Vizdrive/VizDrive_WRO2025/models/README.md

# Models Folder

Here you can find all the .stl and .glb models of every 3D modeled part of our robot.

The .glb models are used for the HTML embeds hosted in GitHub pages. 
We designed these embeds for a more interactive visualization of the models and their colors in the real-life robot. However, the .stl files can also be visualized directly in GitHub.

The designs included in this file directory are:

## 1. Chassis Model

### 1. [Chassis](./chassis/chassis.stl)
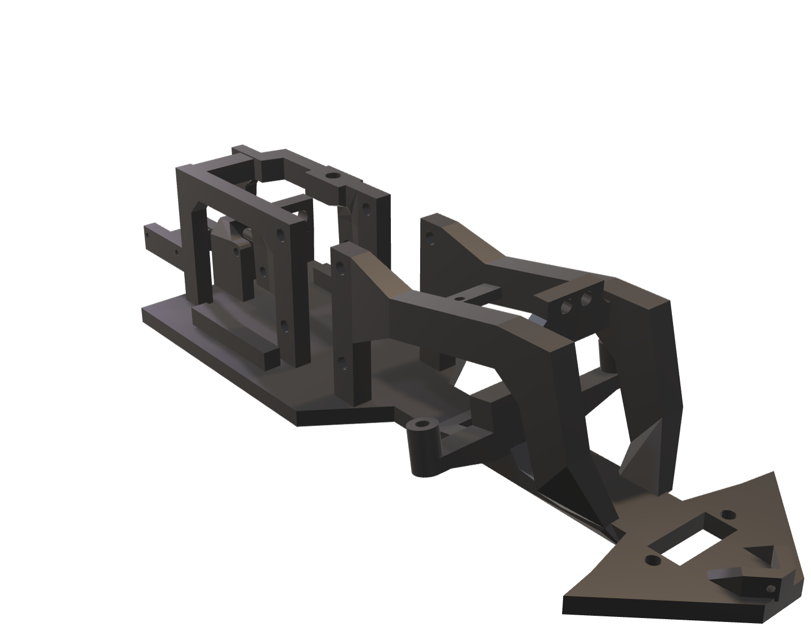
[picture p4: models/chassis/Chassis.png]


Visit the embed: [Chassis Embed](https://vizdrive.github.io/VizDrive_WRO2025/embeds/interactive_chassis)

## 2. Steering

### 1. [Steering Rod an Camera Support](./steering/steering_rods.stl)
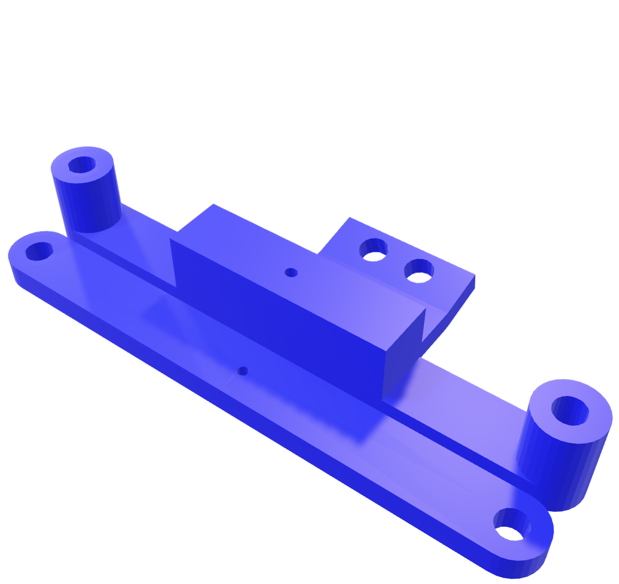
[picture p5: models/steering/SteeringandCamera.png]


Visit the embed: [Steering Rod and Camera Support Embed](https://vizdrive.github.io/VizDrive_WRO2025/embeds/interactive_steering_rods)

## 3. Wheels Models

### 1. [Wheel Hubs](./wheels/wheel_hub.stl)
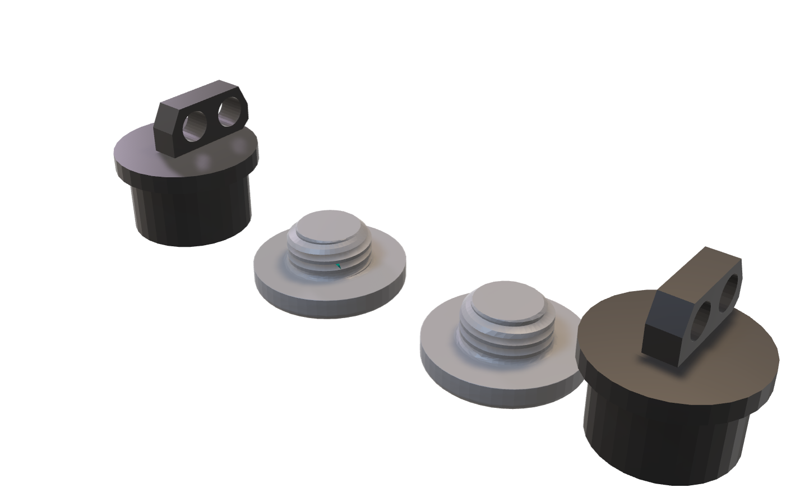
[picture p6: models/wheels/Hubs.png]


Visit the embed: [Wheels Hub Embed](https://vizdrive.github.io/VizDrive_WRO2025/embeds/interactive_hub)

### 2. [Rear Wheels](./wheels/encoder_wheel.stl)
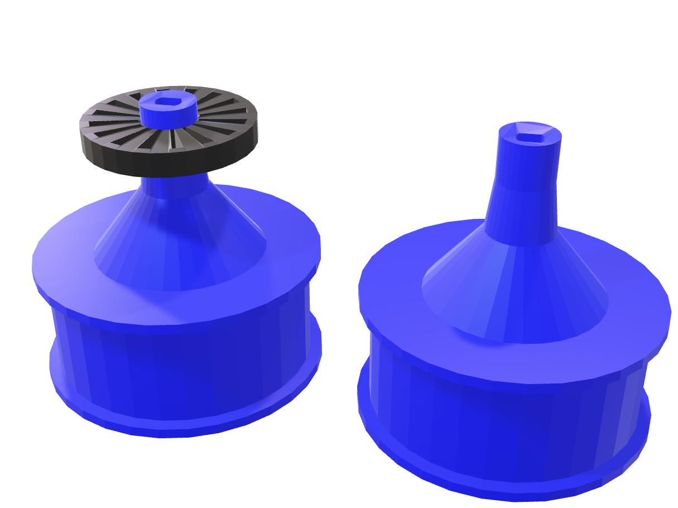
[picture p7: models/wheels/RearWheels.png]


Visit the embed: [Rear Wheels Embed](https://vizdrive.github.io/VizDrive_WRO2025/embeds/interactive_rear_wheels)

### 3. [Wheel Rims](./wheels/wheel_rims.stl)
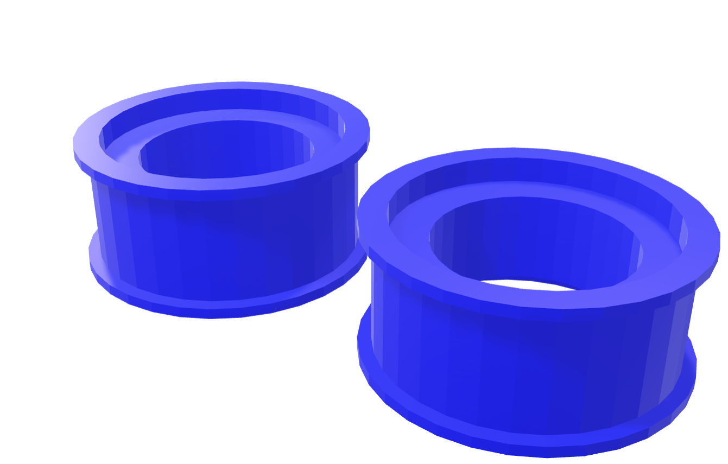
[picture p8: models/wheels/Rims.png]


Visit the embed: [Wheel Rims Embed](https://vizdrive.github.io/VizDrive_WRO2025/embeds/interactive_rims)

---

For an explanation on the design and 3D printing of these models, refer to the document: [**9. 3D Modeling**](./../../docs/09_3d_modeling.md)
