Vizdrive/VizDrive_WRO2025/docs/11_other_resources.md

# 11. Other Resources

This section provides links to supplementary materials, diagrams, and other relevant resources that offer further insight into the VizDrive robot's design, construction, and operation.

## 11.1 Electrical Schematics and Circuit Diagrams

* **Full Circuit and Diagram (PDF):** A comprehensive diagram illustrating all electrical connections and component placements within the robot's circuit.
  * [View Diagram (PDF)](./../schemes/circuit_diagram.pdf)

## 11.2 3D Models

All custom mechanical parts designed for VizDrive are available as STL files. These models can be used for replication, modification, or further study of the robot's physical structure.

* **Chassis:** The main structural frame of the robot.
  * [View 3D Model (STL)](./../models/chassis/chassis.stl)
* **Front Wheel Rims:** Custom-designed rims for the front wheels.
  * [View 3D Model (STL)](./../models/wheels/wheels.stl)
* **Front Wheel Hubs with Screws:** Hubs connecting to the steering rod, including screw designs.
  * [View 3D Model (STL)](./../models/wheels/wheel_hub.stl)
* **Encoder Wheel and Rear Wheel:** Precision-designed wheel with encoder markings and standard rear wheel.
  * [View 3D Model (STL)](./../models/encoder_wheel/)
* **Steering Rods and Camera Support:** Components for steering rods and the PixyCam mount.
  * [View 3D Model (STL)](./../models/steering/steering_rods.stl)

## 11.3 MPU Calibration Data Visualization

* **Accumulated Error vs. Number of Samples Graph:** This chart illustrates the empirical data collected during MPU calibration, demonstrating the reduction in accumulated error as the number of samples increases, guiding the selection of optimal calibration parameters.

View Calibration Data Graph (PNG)

## 11.4 Supplementary Media

* **Robot Images/Videos:**

---
[Back to Main README.md Index](../README.md)
