Vizdrive/VizDrive_WRO2025/assets/flowcharts/flowchart.png

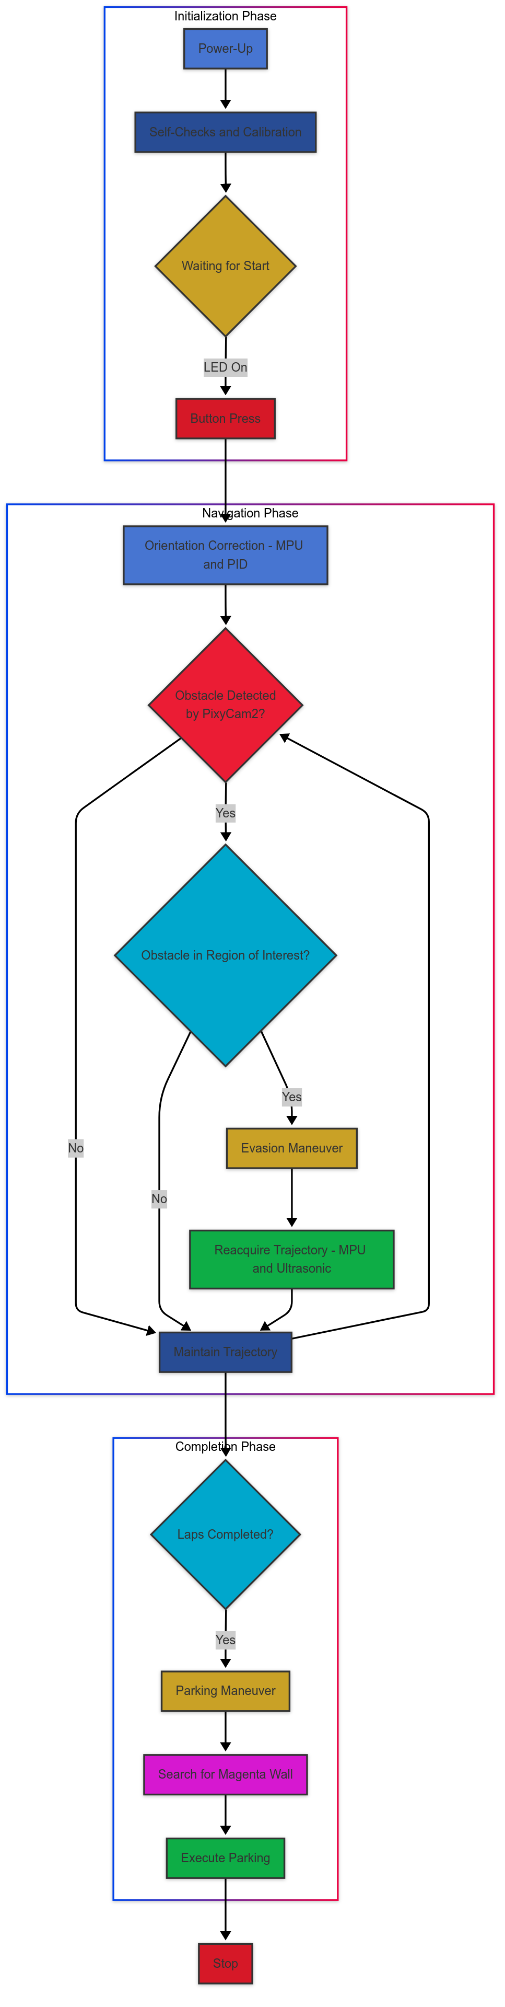
assets/flowcharts/flowchart.png
