Vizdrive/VizDrive_WRO2025/assets/hardware_photos/encoder_pins.jpg

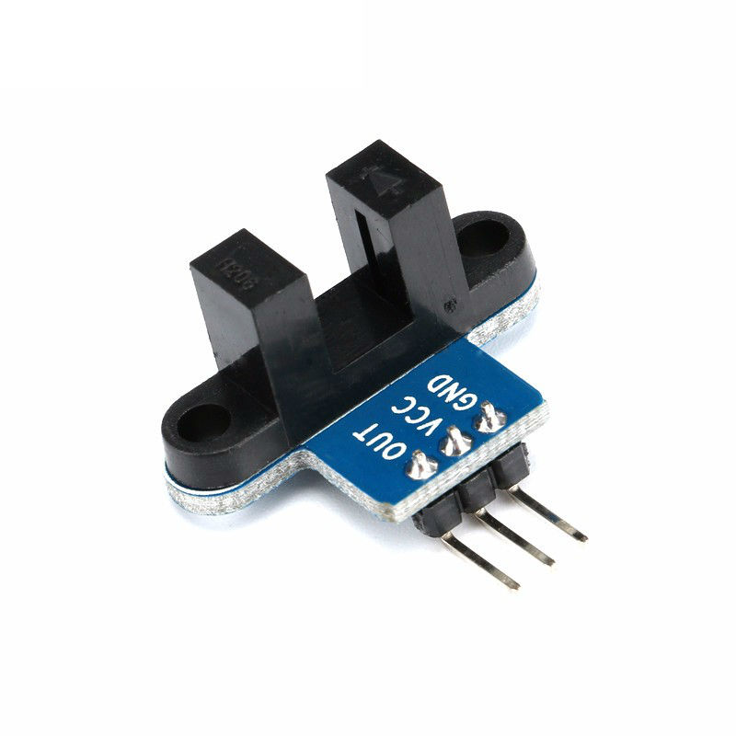
assets/hardware_photos/encoder_pins.jpg
