Vizdrive/VizDrive_WRO2025/assets/hardware_photos/imagen (6).jpg

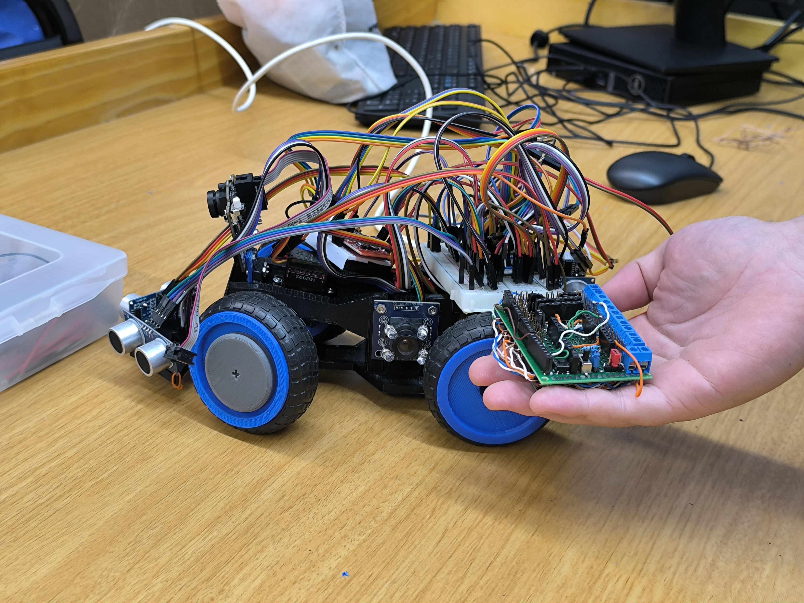
assets/hardware_photos/imagen (6).jpg
