Vizdrive/VizDrive_WRO2025/assets/hardware_photos/imagen (17).jpg

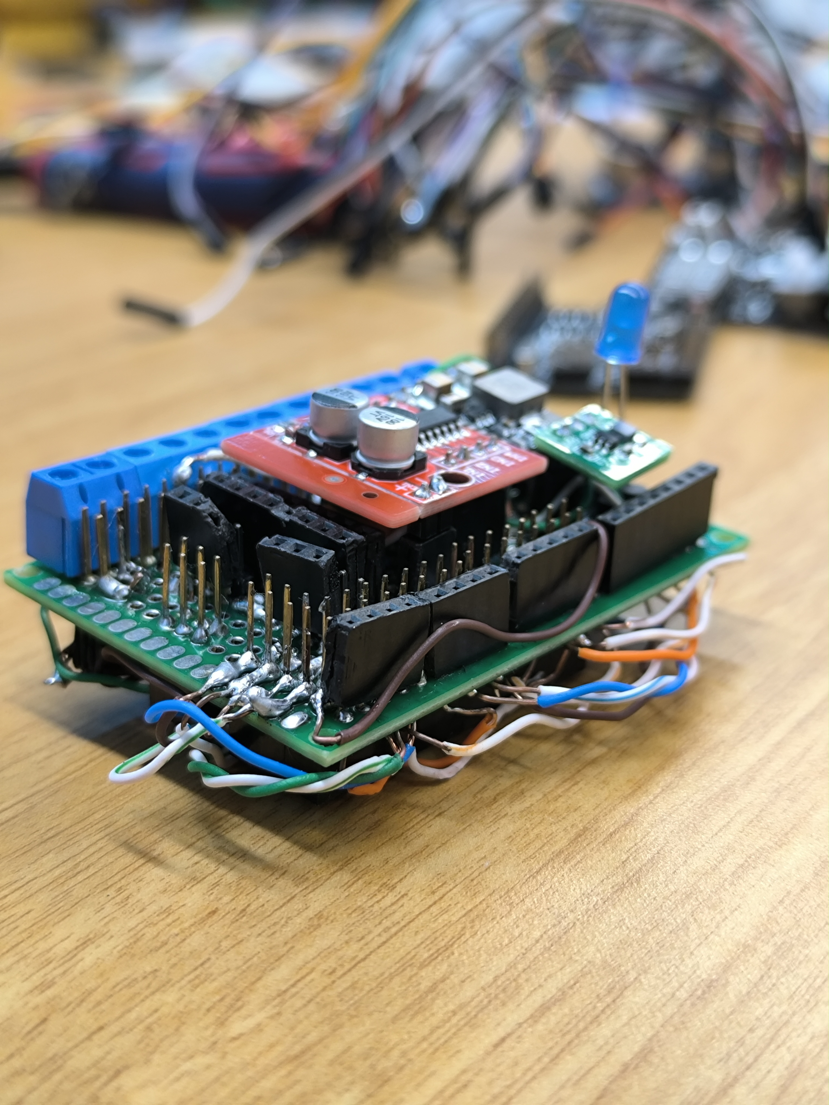
assets/hardware_photos/imagen (17).jpg
