Vizdrive/VizDrive_WRO2025/schemes/electromechanical_diagram.png

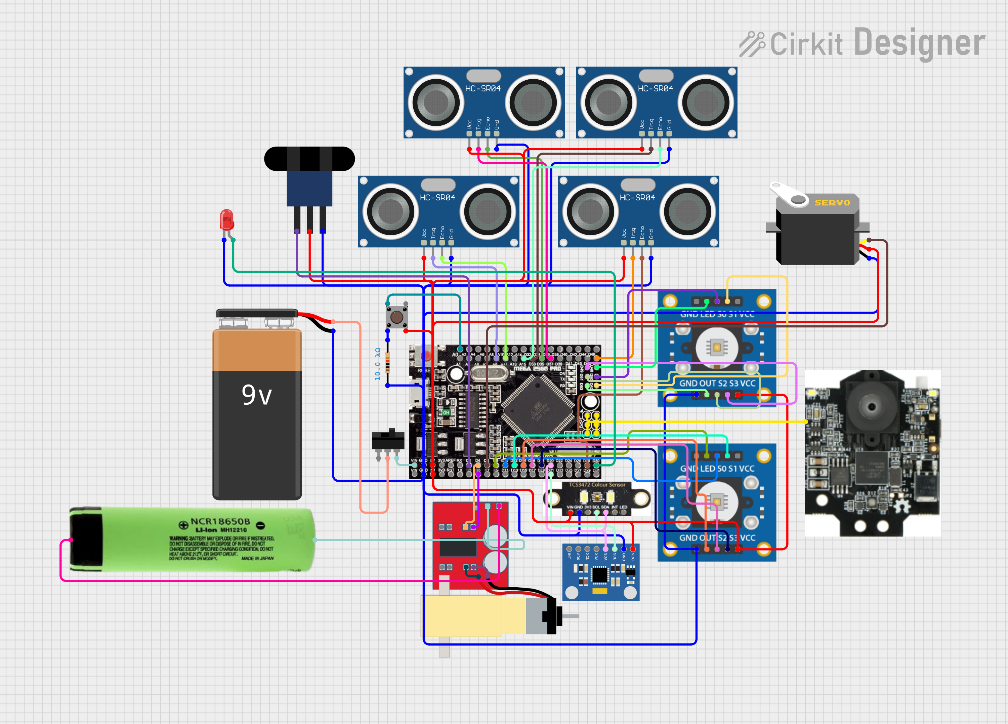
schemes/electromechanical_diagram.png
