Vizdrive/VizDrive_WRO2025/t-photos/aislinn_1.jpg

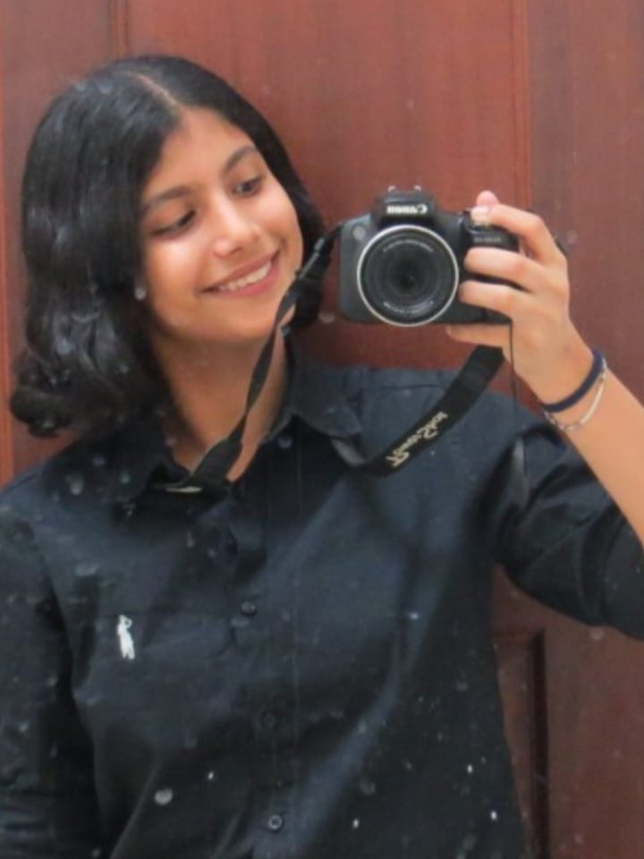
t-photos/aislinn_1.jpg
