Vizdrive/VizDrive_WRO2025/models/chassis/chassis.stl

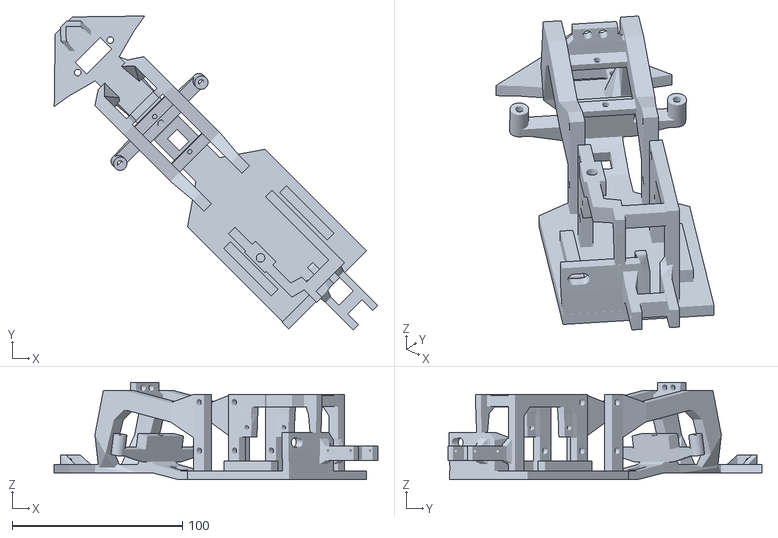
[picture p54: CAD file, 2025-06-26]
models/chassis/chassis.stl
189.9 x 184.2 x 56.9
