Vizdrive/VizDrive_WRO2025/models/wheels/wheel_hub.stl

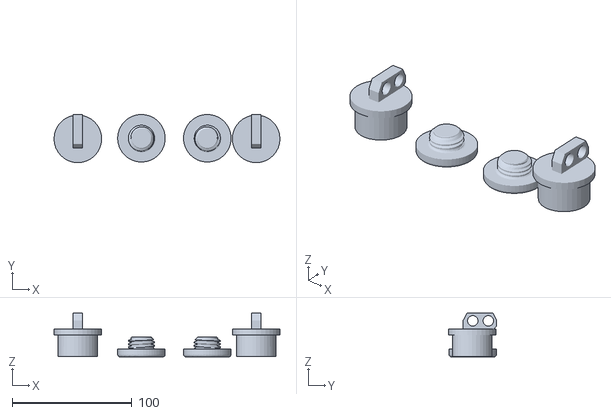
[picture p55: CAD file, 2025-06-29]
models/wheels/wheel_hub.stl
188.9 x 40.4 x 36.7
