Vizdrive/VizDrive_WRO2025/models/wheels/wheel_rims.stl

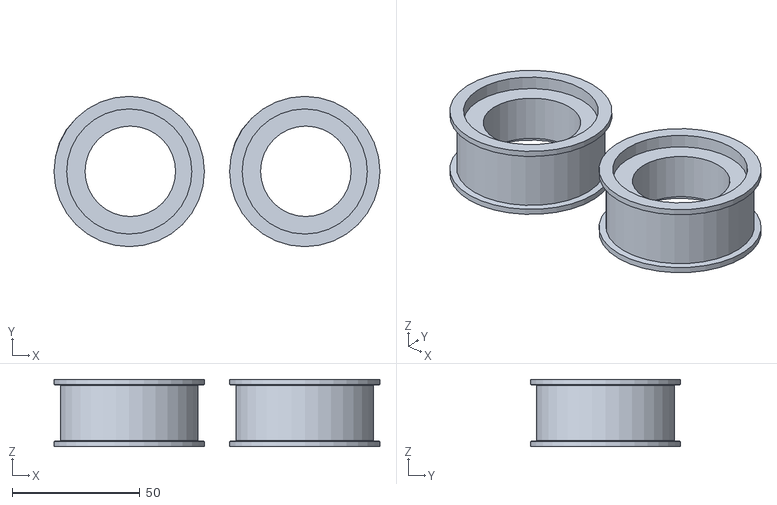
[picture p56: CAD file, 2025-06-29]
models/wheels/wheel_rims.stl
127.5 x 58.8 x 26.4
