Vizdrive/VizDrive_WRO2025/models/wheels/encoder_wheel.stl

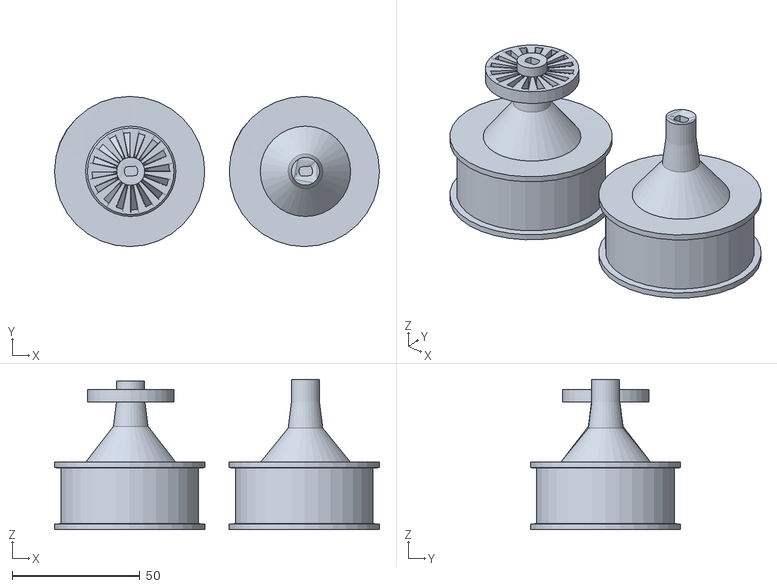
[picture p57: CAD file, 2025-06-26]
models/wheels/encoder_wheel.stl
127.3 x 58.9 x 58.8
