Vizdrive/VizDrive_WRO2025/assets/data_graphs/MPU Calibration Data Analysis.xlsx

samples | accumulated error
10 | 0.105206
25 | 0.132352
50 | 0.065165
100 | 0.032352
150 | 0.014112
200 | 0.004077
300 | 0.003492
500 | 0.002473
750 | 0.001029
1000 | 0.001671
