Vizdrive/VizDrive_WRO2025/(commit log)

2025-06-26 Uploaded all files of the documentation for VizDrive_WRO2025
    [chassis.stl, encoder_wheel.stl]
2025-06-26 Corrected interactive_circuit.html
    Updated the Cirkit Circuit model
2025-06-26 Updated README.md Interactive Circuit Web Address
2025-06-29 Update 04_sensors_and_pin_configuration.md
    Edited the ultrasonic functionalities for a more precise explanation.
2025-06-29 Update 07_pixycam_computer_vision.md
    Updated the ultrasonic sensors' different additional functions, added code snippets and more in-depth explanations.
2025-06-29 Update and rename wheels.md to README.md
    For information of the directory. Renamed, and added the information.
2025-06-29 Added .stl models of wheels
    [wheel_hub.stl, wheel_rims.stl]
2025-06-29 Update README.md
    Changed the routes to the .stl models and .png images.
2025-06-29 Uploaded Data Graphs .xlsx and .png
    [MPU Calibration Data Analysis.xlsx, Ultrasonic Sensors Data Analysis.xlsx]
2025-06-29 Update README.md
    Corrected the name of the ultrasonic sensor data graph .png
2025-06-29 Create 08_ultrasonic_distance_sensing.md
    Divided 07_pixycam_computer_vision into two separate .md files for pixycam detection and ultrasonic sensing, to improve modularity and readability.
2026-07-26 Add circuit design section to hardware components
    Added section on circuit design and included image.
2026-07-26 Adjust PCB image height in hardware components documentation
    Increased the image height of the PCB photo for better visibility.
2026-08-31 Increase steering angle capability to 55 degrees
    Updated the steering angle capability from 45 degrees to 55 degrees for improved maneuverability.
2026-09-01 Update PID control explanation and integral term rationale
    Clarified the role of the integral term in PID control and explained exclusion of integral term in the steering mechanism due to high dynamics.
2026-09-01 Update explanation for integral term exclusion in PID
    Clarify the reasoning for setting the integral term to zero in the PID control loop, emphasizing the absence of persistent lateral bias forces.
2026-09-02 Enhance ultrasonic distance sensing documentation
    Added section on side proportional control for obstacle avoidance and updated yaw application details.
2026-09-03 Refine camera settings and obstacle evasion logic
    Updated camera configuration parameters and added anti-jittering function for improved blob detection. Enhanced obstacle evasion logic and refined serial communication handling.
